TempPortfolio/LinkyReader_Kicad/LinkyReaderSNEC.kicad_pcb

## KiCad design LinkyReaderSNEC.kicad_pcb (2024-08-27)

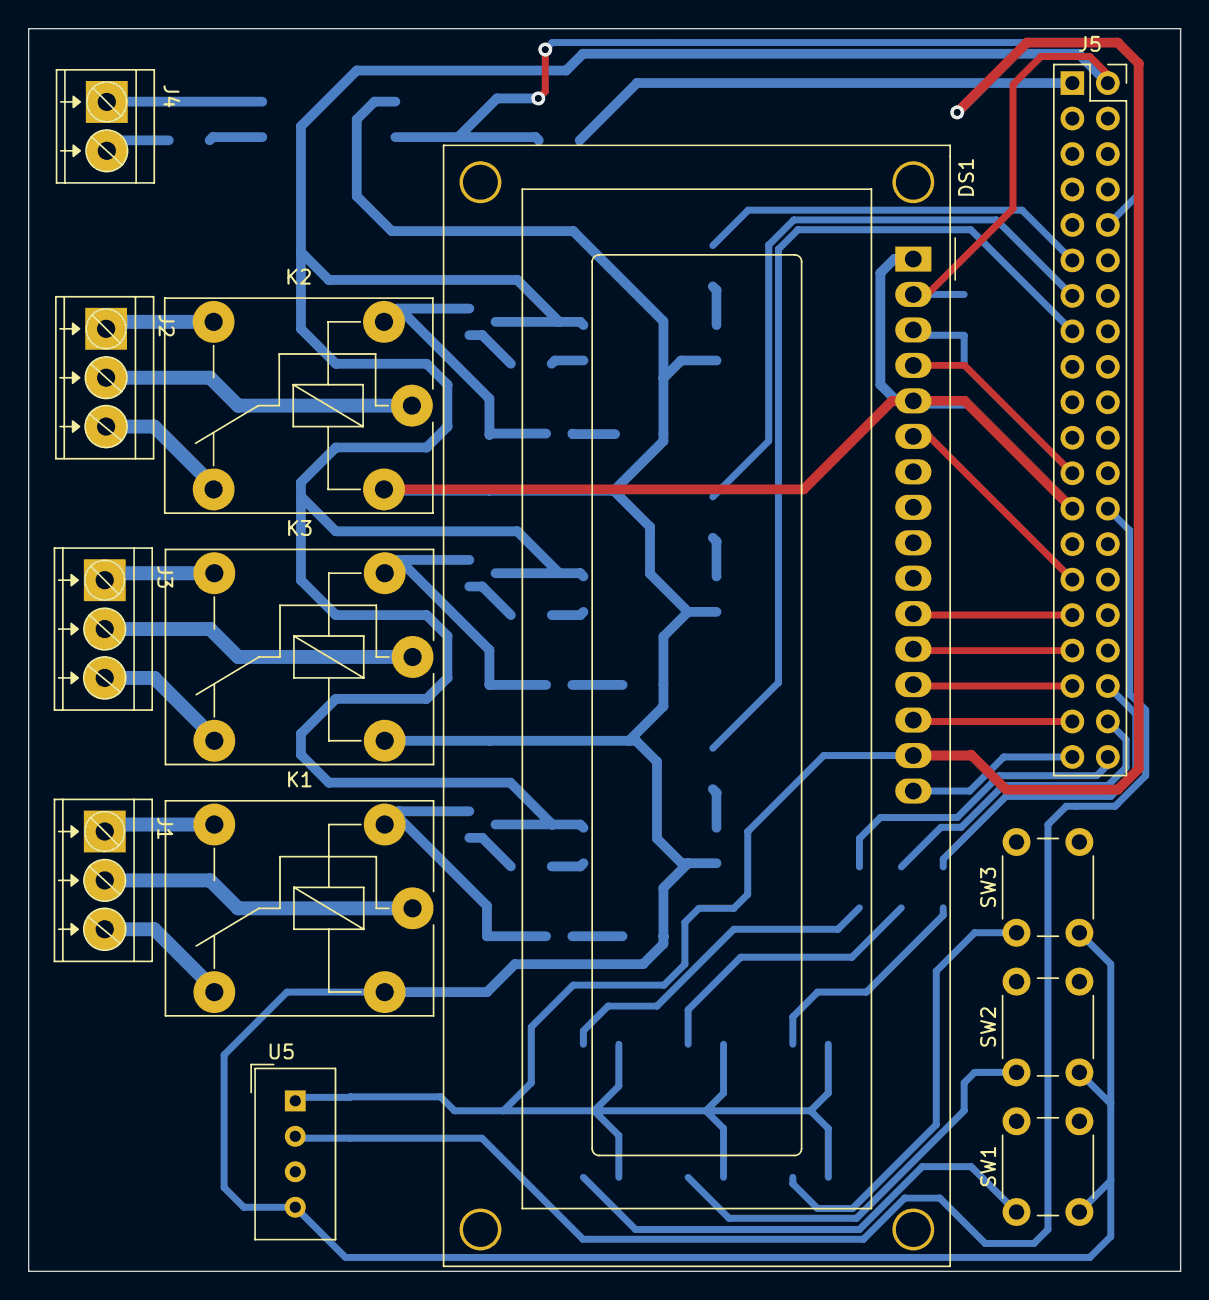
[picture p26: board LinkyReaderSNEC.kicad_pcb from above]

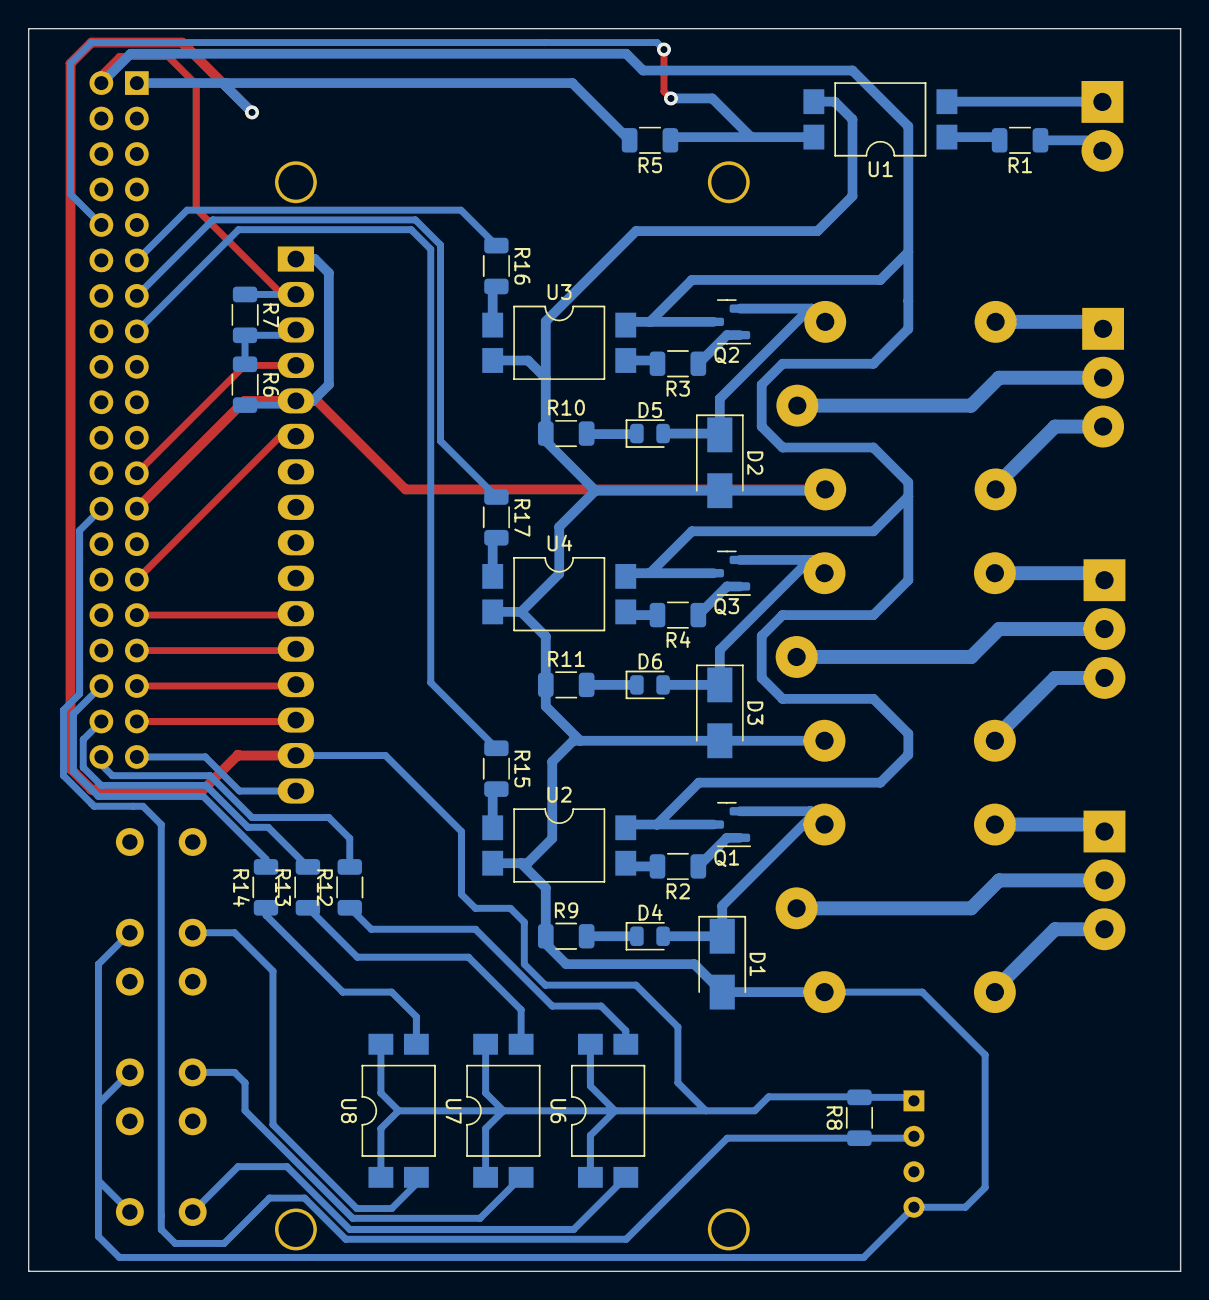
[picture p27: board LinkyReaderSNEC.kicad_pcb from below]

Board: 2 copper layers, 82.5 x 89.0 mm, 46 parts (33 on the bottom side), 52 nets.

Parts:
D1, D2, D3: D; D_SMA
D4, D5, D6: LED; LED_0805_2012Metric
DS1: WC1602A
J1, J2, J3: Screw_Terminal_01x03; terminal_x1_x3
J4: Screw_Terminal_01x02; terminal_x1_x2
J5: Conn_02x20_Odd_Even; PinSocket_2x20_P2.54mm_Vertical
K1, K2, K3: FINDER-36.11; Relay_SPDT_Finder_36.11
Q1, Q2, Q3: Q_NPN_BEC; SOT-23
R1, R2, R3, R4, R6, R7, R8: 1.2k; R_1206_3216Metric
R5, R9, R10, R11: 3.3k; R_1206_3216Metric
R12, R13, R14, R15, R16, R17: 220; R_1206_3216Metric
SW1, SW2, SW3: SW_DIP_x02; SW_PUSH_6mm_H5mm
U1, U2, U3, U4, U6, U7, U8: SFH6206-2T; SMDIP-4_W9.53mm_Clearance8mm
U5: DHT11; Aosong_DHT11_5.5x12.0_P2.54mm

Connections:
+3.3V: DS1.15 (LED(+)), J5.1, R5.2, R8.2, U5.1 (VCC), U6.1, U6.4, U7.1, U7.4, U8.1, U8.4
+5V: DS1.2 (VDD), J5.2, Q1.3 (C), Q2.3 (C), Q3.3 (C), R7.1, U2.4, U3.4, U4.4
GND: D1.2 (A), D2.2 (A), D3.2 (A), DS1.1 (VSS), DS1.5 (R/W), J5.25, K1.A2, K2.A2, K3.A2, R6.2, R9.1, R10.1, R11.1, SW1.2, SW2.2, SW3.2, U1.3, U2.2, U3.2, U4.2, U5.4 (GND)
unnamed: D1.1 (K), D4.2 (A), K1.A1, Q1.2 (E)
unnamed: D2.1 (K), D5.2 (A), K2.A1, Q2.2 (E)
unnamed: D3.1 (K), D6.2 (A), K3.A1, Q3.2 (E)
unnamed: D4.1 (K), R9.2
unnamed: D5.1 (K), R10.2
unnamed: D6.1 (K), R11.2
unnamed: DS1.3 (VO), R6.1, R7.2
unnamed: DS1.4 (RS), J5.23
unnamed: DS1.6 (E), J5.29
unnamed: DS1.11 (D4), J5.31
unnamed: DS1.12 (D5), J5.33
unnamed: DS1.13 (D6), J5.35
unnamed: DS1.14 (D7), J5.37
unnamed: DS1.16 (LED(-)), J5.39
unnamed: J1.1, K1.14
unnamed: J1.2, K1.11
unnamed: J1.3, K1.12
unnamed: J2.1, K2.14
unnamed: J2.2, K2.11
unnamed: J2.3, K2.12
unnamed: J3.1, K3.14
unnamed: J3.2, K3.11
unnamed: J3.3, K3.12
unnamed: J4.1, U1.2
unnamed: J4.2, R1.1
unnamed: J5.10, R5.1, U1.4
unnamed: J5.11, R16.1
unnamed: J5.13, R17.1
unnamed: J5.15, R15.1
unnamed: J5.26, R8.1, U5.2 (IO)
unnamed: J5.36, R14.2
unnamed: J5.38, R13.2
unnamed: J5.40, R12.2
unnamed: Q1.1 (B), R2.1
unnamed: Q2.1 (B), R3.1
unnamed: Q3.1 (B), R4.1
unnamed: R1.2, U1.1
unnamed: R2.2, U2.3
unnamed: R3.2, U3.3
unnamed: R4.2, U4.3
unnamed: SW1.1, U6.2
unnamed: SW2.1, U7.2
unnamed: SW3.1, U8.2
unnamed: R15.2, U2.1
unnamed: R16.2, U3.1
unnamed: R17.2, U4.1
unnamed: R12.1, U6.3
unnamed: R13.1, U7.3
unnamed: R14.1, U8.3
